havenxie/handware-X-LINK/PC Tools/readme.txt

ST-LinkUpgrade.exe用于升级STlink固件。
STLinkReflash 用于刷成JLINK

以下两个数据流请结合文档：https://www.brobwind.com/archives/1133  分析
获取方式： STLINKReflash -v -u

USBDfu-flow-2-stlinkV2.1: STLinkReflash从jlink-OB升级到ST-LinkV2.1的USB数据流
USBDfu-flow-2-jlink-OB:   STLinkReflash从ST-LinkV2.1升级到jlink-OB的USB数据流
