havenxie/handware-X-LINK/Hardware/X-LINK-A_V1.0/ST-Link-V1.0.pdf

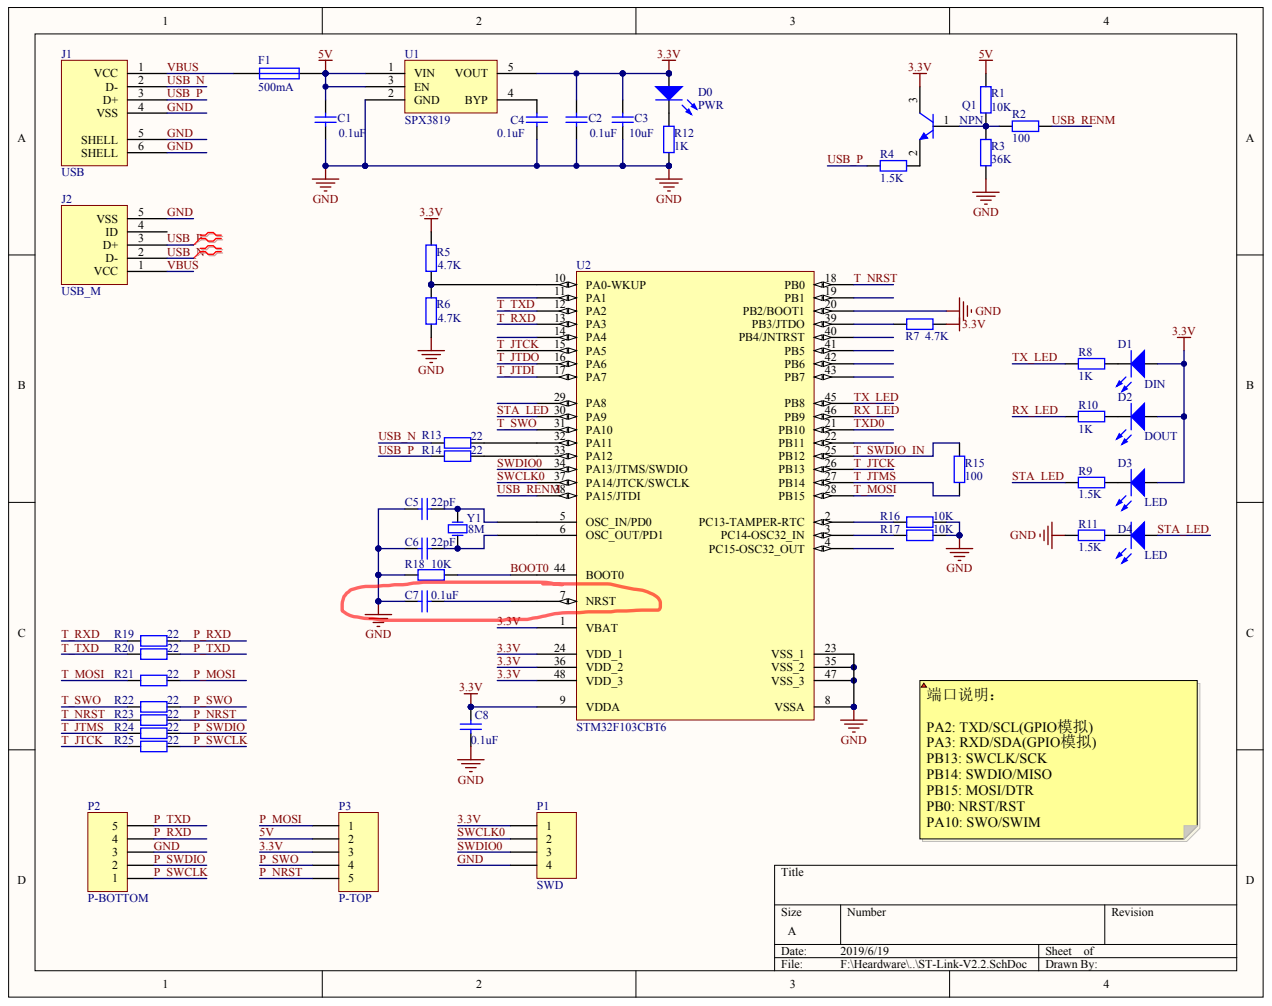
[picture p6: page 1]

Y1
8M | OSC_OUT/PD1 6 | R17 | 10K

Size A | Number | Revision

Date: 2019/6/19 | Sheet of
File: F:\Heardware\..\ST-Link-V2.2.SchDoc | Drawn By:

Bill of Materials | <Parameter Title not found>
Source Data From: | ST-Link-V2.2.PrjPcb
Project: | | ST-Link-V2.2.PrjPcb
Variant: | | None
Creation Date: 2019/6/19 | 18:35:20
Print Date: | 43635 | 43635.77461
Footprint | Comment | LibRef | Designator | Description | Quantity
| | | | | 8
C-0603 | Cap | Cap | C1, C2, C3, C4, C5, C6, C7, C8 | Capacitor, Capacitor, Capacitor, Capacitor,
| | | | [NoValue], [NoValue], [NoValue], Capacitor
SMT_LED_0
603 | PWR | LED2 | D0 | Typical RED, GREEN, YELLOW, AMBER
| | | | GaAs LED | 1

SMT_LED_0

603 | DIN | LED2 | D1 | Typical RED, GREEN, YELLOW, AMBER
| | | | GaAs LED | 1

SMT_LED_0

603 | DOUT | LED2 | D2 | Typical RED, GREEN, YELLOW, AMBER
| | | | GaAs LED | 1

SMT_LED_0

603 | LED | LED2 | D3, D4 | Typical RED, GREEN, YELLOW, AMBER
| | | | GaAs LED | 2
0805-1 | Fuse1 | Fuse1 | F1 | 保险丝 | 1
USB-B | USB | USB | J1 | USB接口 | 1
USB_MICRO _5S_B | USB_M | USB_M | J2 | Micro/Mini USB | 1
SIP4-1.27 | SWD | Header 4 | P1 | Header, 4-Pin | 1
HEADER_5 | P-BOTTOM | Header 5 | P2 | Header, 5-Pin | 1
HEADER_5 | P-TOP | Header 5 | P3 | Header, 5-Pin | 1
SOT23-3 | NPN | NPN1 | Q1 | 贴片三极管 | 1
0603-1 | Res1 | Res1 | R1, R2, R3, R4, R16, R17 | 贴片电阻 | 6
0603-1 | Res2 | Res2 | R5, R6, R7, R8, R9, R10, R11, R12, R13,
| | | R14, R15, R18, R19, R20, R21, R22, R23,
| | | R24, R25 | Resistor | 19
SOT23-5 | SPX3819 | SPX3819 | U1 | 1
LQFP48_N | STM32F103CBT
| 6 | STM32F103C8T
| | 6
U2 | STM32 ARM-based 32-bit MCU with 64
Kbytes Flash, 48-pin LQFP, Industrial Temperature
| | | | 1

XAL5032 2-
Leads
8M | XTAL | Y1 | Crystal Oscillator | 1
| | | | 48
Approved | Notes
