havenxie/handware-X-LINK/(list of files, drawings)

Other design files:
Hardware/X-LINK-A_V1.0/ST-Link-V1.0.PrjPcb
Hardware/X-LINK-A_V1.0/ST-Link-V1.0.SchDoc
Hardware/X-LINK-A_V2.0/X-LINK-A_V2.0.PrjPcb
Hardware/X-LINK-A_V2.0/X-LINK-A_V2.0.SchDoc
