havenxie/handware-X-LINK/(commit log)

2018-11-27 commit message
    [ST-Link-V2.2-Mini.PcbLib, ST-Link-V2.2-Mini.PrjPcb, ST-Link-V2.2-Mini.SchDoc, ST-Link-V2.2.PrjPcb, ST-Link-V2.2.SchDoc]
2018-11-27 CMSIS-DAP firmware build first ok!
    [Bluepill CMSIS-DAP Pin-config.txt]
2018-12-04 building hex for V2B
    [ST-Link-V2.2-Mini.PrjPcb, ST-Link-V2.2-Mini.SchDoc]
2018-12-08 1.Add PA15 to reset USB 2.Modified interrupt vector table to support bootloader for ST-Link-V2.1
    [main.c]
2018-12-27 connecting led fast running
2019-01-06 add pwm mode for green led
2019-01-06 modified headware : LED_G -> LED_B
    [ST-Link-V2.2-Mini.PrjPcb, ST-Link-V2.2-Mini.SchDoc]
2019-01-20 add cad file
    [ST-Link-V2.2-Mini-Silk.dwg, ST-Link-V2.2-Mini.PrjPcb]
2019-01-20 1.removed other board except v21/v2b; 2.add hex2bin and hex2dfu
    [Bluepill CMSIS-DAP Pin-config.txt]
2019-04-27 rename heardware
    [ST-Link-V2.2-Mini-Silk.dwg, ST-Link-V2.2-Mini.PcbLib, ST-Link-V2.2-Mini.PrjPcb, ST-Link-V2.2-Mini.SchDoc, ST-Link-V2.2.PrjPcb, ST-Link-V2.2.SchDoc, X-LINK-A_V2.0.PrjPcb, X-LINK-A_V2.0.SchDoc]
2019-06-08 删除一个PC工具
2019-06-19 添加bootloader_v2.2以支持STM32 ST-LINK Utility V4.5.0
2019-07-25 rename headware
    [ST-Link-V1.0.PrjPcb, ST-Link-V1.0.SchDoc, ST-Link-V2.2.PrjPcb, ST-Link-V2.2.SchDoc, X-LINK-A_V2.0.PrjPcb, X-LINK-A_V2.0.SchDoc]
2019-08-13 modified pcb, move usb position
    [X-LINK-A_V2.0.PrjPcb]
2019-10-17 modified hardware pdf
    [X-LINK-A_V2.0.PrjPcb, X-LINK-A_V2.0.SchDoc]
2019-10-18 recreated pdf
    [X-LINK-A_V2.0.PrjPcb, X-LINK-A_V2.0.SchDoc]
